Linux-enCaja/droidstamp-hw/droidstamp_mx233/DDR1.sch

## KiCad design droidstamp_mx233/DDR1.sch (2012-11-19)

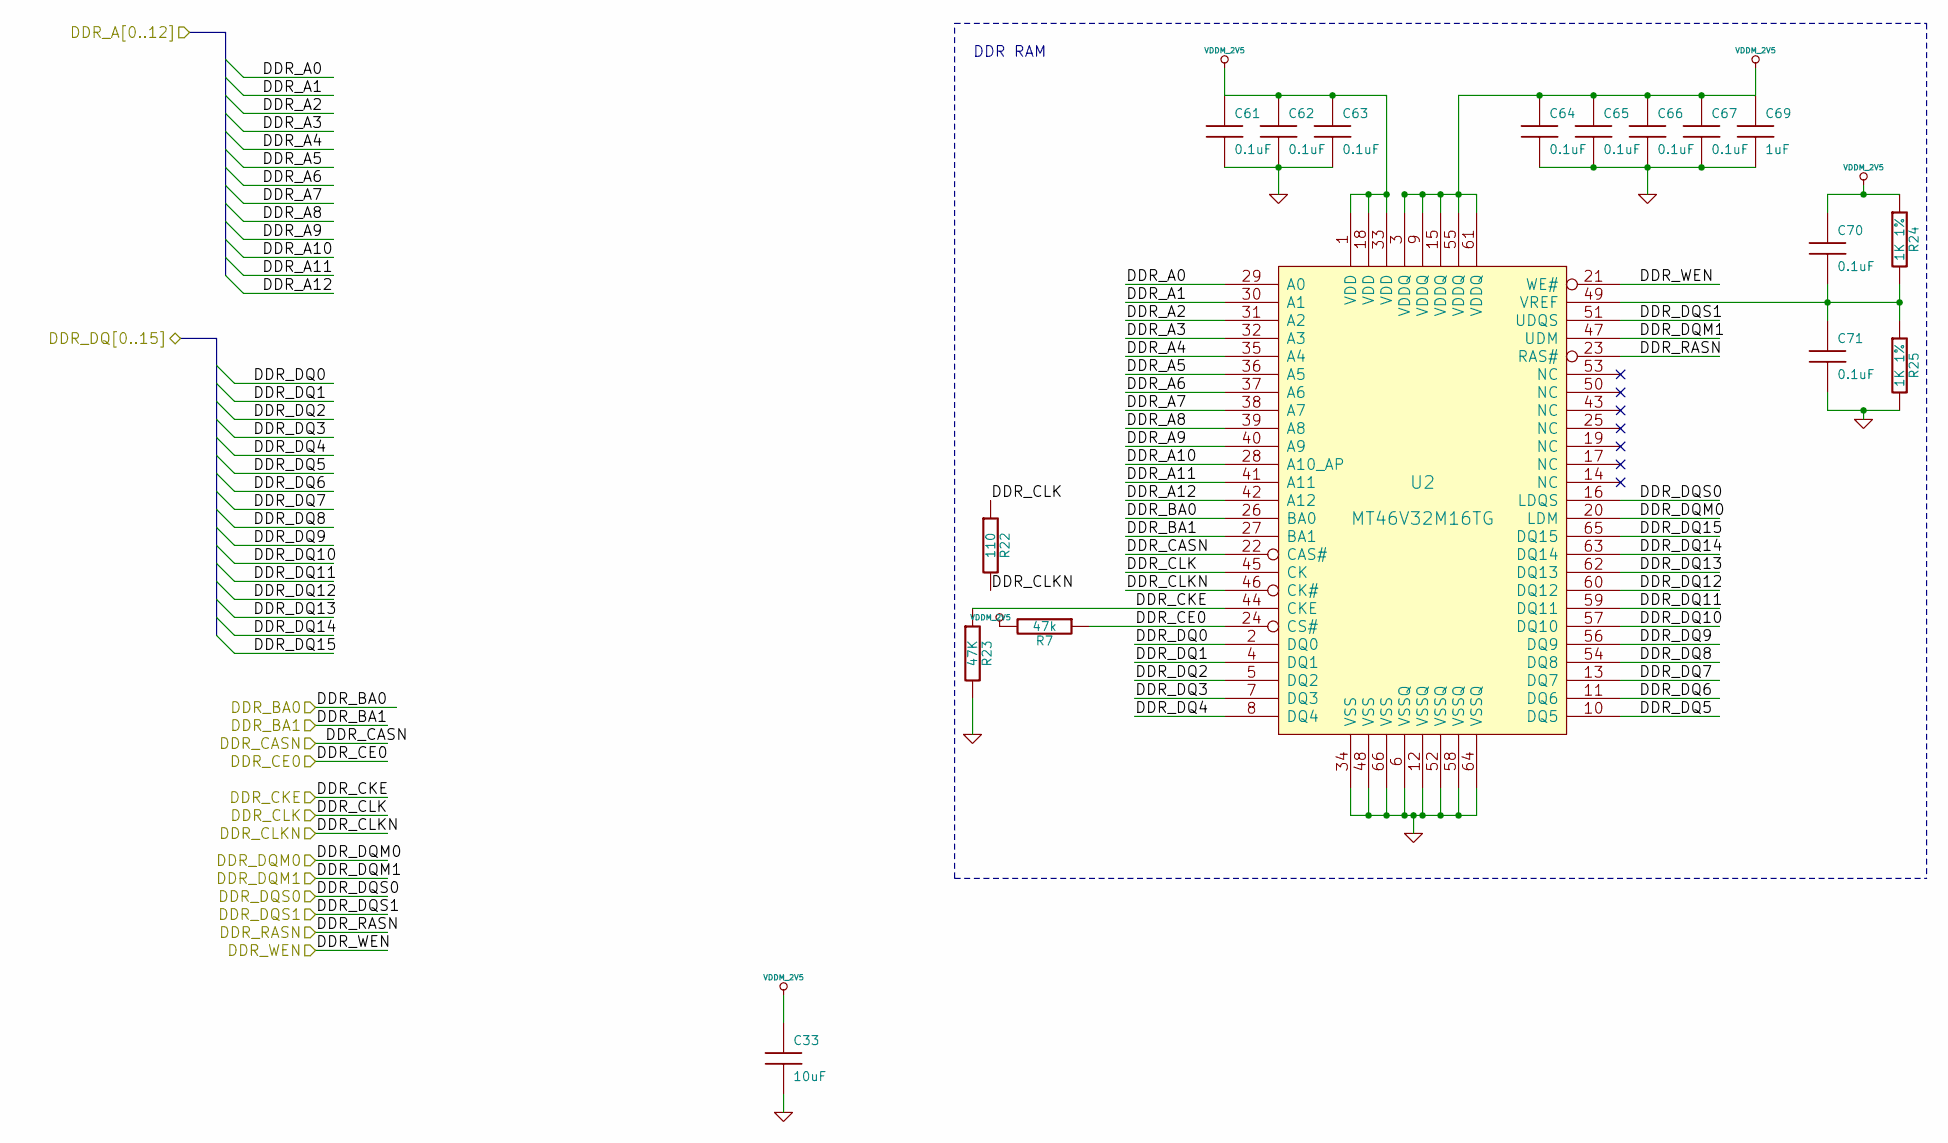
[picture p1: schematic DDR1.sch]

Parts:
C33: 10uF; SM1206
C61, C62, C63, C64, C65, C66, C67, C70, C71: 0.1uF
C69: 1uF
R7: 47k
R22: 110
R23: 47K
R24, R25: 1K 1%
U2: MT46V32M16TG; TSOP66_JEDEC_DDR_SDRAM

Connections:
DDR_A0: U2.29 (A0)
DDR_A1: U2.30 (A1)
DDR_A2: U2.31 (A2)
DDR_A3: U2.32 (A3)
DDR_A4: U2.35 (A4)
DDR_A5: U2.36 (A5)
DDR_A6: U2.37 (A6)
DDR_A7: U2.38 (A7)
DDR_A8: U2.39 (A8)
DDR_A9: U2.40 (A9)
DDR_A10: U2.28 (A10_AP)
DDR_A11: U2.41 (A11)
DDR_A12: U2.42 (A12)
DDR_BA0: U2.26 (BA0)
DDR_BA1: U2.27 (BA1)
DDR_CASN: U2.22 (CAS#)
DDR_CE0: R7.1, U2.24 (CS#)
DDR_CKE: R23.1, U2.44 (CKE)
DDR_CLK: R22.1, U2.45 (CK)
DDR_CLKN: R22.2, U2.46 (CK#)
DDR_DQ0: U2.2 (DQ0)
DDR_DQ1: U2.4 (DQ1)
DDR_DQ2: U2.5 (DQ2)
DDR_DQ3: U2.7 (DQ3)
DDR_DQ4: U2.8 (DQ4)
DDR_DQ5: U2.10 (DQ5)
DDR_DQ6: U2.11 (DQ6)
DDR_DQ7: U2.13 (DQ7)
DDR_DQ8: U2.54 (DQ8)
DDR_DQ9: U2.56 (DQ9)
DDR_DQ10: U2.57 (DQ10)
DDR_DQ11: U2.59 (DQ11)
DDR_DQ12: U2.60 (DQ12)
DDR_DQ13: U2.62 (DQ13)
DDR_DQ14: U2.63 (DQ14)
DDR_DQ15: U2.65 (DQ15)
DDR_DQM0: U2.20 (LDM)
DDR_DQM1: U2.47 (UDM)
DDR_DQS0: U2.16 (LDQS)
DDR_DQS1: U2.51 (UDQS)
DDR_RASN: U2.23 (RAS#)
DDR_WEN: U2.21 (WE#)
GND: C33.2, C61.2, C62.2, C63.2, C64.2, C65.2, C66.2, C67.2, C69.2, C71.2, R23.2, R25.2, U2.6 (VSSQ), U2.12 (VSSQ), U2.34 (VSS), U2.48 (VSS), U2.52 (VSSQ), U2.58 (VSSQ), U2.64 (VSSQ), U2.66 (VSS)
unnamed: C70.2, C71.1, R24.2, R25.1, U2.49 (VREF)
VDDM_2V5: C33.1, C61.1, C62.1, C63.1, C64.1, C65.1, C66.1, C67.1, C69.1, C70.1, R7.2, R24.1, U2.1 (VDD), U2.3 (VDDQ), U2.9 (VDDQ), U2.15 (VDDQ), U2.18 (VDD), U2.33 (VDD), U2.55 (VDDQ), U2.61 (VDDQ)

Notes on the sheet:
DDR RAM
