Linux-enCaja/droidstamp-hw/droidstamp_mx233/STM32.sch

## KiCad design droidstamp_mx233/STM32.sch (2012-11-19)

Schematic: STM32.sch

Parts:
C19, C21: 2.2uF; SM0805
C26, C28: 22pF; SM0603
C54: .1uF; SM0603
C55, C56, C58, C72: 0.1uF; SM0603
C59: 10uF Tant.; SM1206
C73: 1uF; SM0805
C74, C76: 33uF; SM1206
C75: 100n; SM0603
D8, D9: LED; SM0603
L14, L15: 2A 120 ohm; SM0805
P6: CONN_10X2; pin_array_10x2
P8: CONN_12X2; pin_array_12x2
P9: CONN_8X2; pin_array_12x2
Q2, Q3, Q4, Q5, Q6, Q7, Q8, Q9: BS170F
R5, R33: 1k; SM0603
R26, R47: 4.7k; SM0603
R27, R34: 10k; SM0603
R35, R37, R38, R39, R40, R41, R44, R45: 2.2k; SM0603
R46: 150; SM0603
U10: STM32F105RC; TQFP_64
U11: LT1117CST-3.3; LT1117
U12, U13, U14, U15: ZXMHC3F381N8; -SO8
X3: 12MHz; ABM8G

Notes on the sheet:
C19, C21 2.2uF para cortex M4 C19. C21 = Ohms para cortex M3
DECOUPLING
LEDS
