Linux-enCaja/droidstamp-hw/droidstamp_mx233/i.MX233.sch

## KiCad design droidstamp_mx233/i.MX233.sch (2012-11-19)

Schematic: i.MX233.sch

Parts:
BT1: BATTERY
C1, C2, C3, C5, C23, C24, C31, C32, C37, C41, C44, C46, C47, C49, C51, C57, C60, C68: 0.1uF
C4: .1uF
C17, C25, C29, C38, C42, C43, C50: 1uF
C22, C30, C36, C45: 0.01uF
C27, C35, C39: 33uF
C34: 4.7uF
C40, C48: 33uF Ceramic
C52, C53: 20 pF
D1: 10BQ015
D2, D3, D4, D5: LED
IC1: iMX233
J1: MICROSD
J5: JACK-PLUG; DC_JACK
JP1, JP2, JP3: JUMPER
L1: 15uH
L2, L8: HZ0805D152R-10 (1500 ohm)
L11, L12, L13: HZ0805D152R-10 (1500 ohm); SM0805
P1: CONN_12X2
P2: CONN_12X2
P3, P5, P7, P10: CONN_1; MHOLE
P4: CONN_4X2
Q1: MMDT3904; SOT363_PHILIPS
R1: 1
R2, R3: 0.1
R4: 1K
R6: 100K
R8, R51, R52: 10k
R9, R13, R16, R28, R30, R31: 1k
R10: 47K
R11, R12, R14: 1.5k
R15, R17, R18, R19: 11k
R29, R32: 47k
U1: ADM3101E; QSOP16
U3: M25P32; SO16W
X1: 24MHz; ABM8G

Notes on the sheet:
Para hacer boot por la SD soldar R48, R49 no se solda Para hacer boot por la memoria SPI soldar R49, R48 no se solda
ADM3101E CIRCUIT
UART CONNECTOR
Power Supply
MICRO_SD
USB CONNECTOR
IMX233 PROCESSOR
POWER SUPPLY AND DECOUPLING
BOOT MODES
RESET CIRCUIT
