Linux-enCaja/droidstamp-hw/droidstamp_pcb_emeter/STM32.sch

## KiCad design droidstamp_pcb_emeter/STM32.sch (2012-08-21)

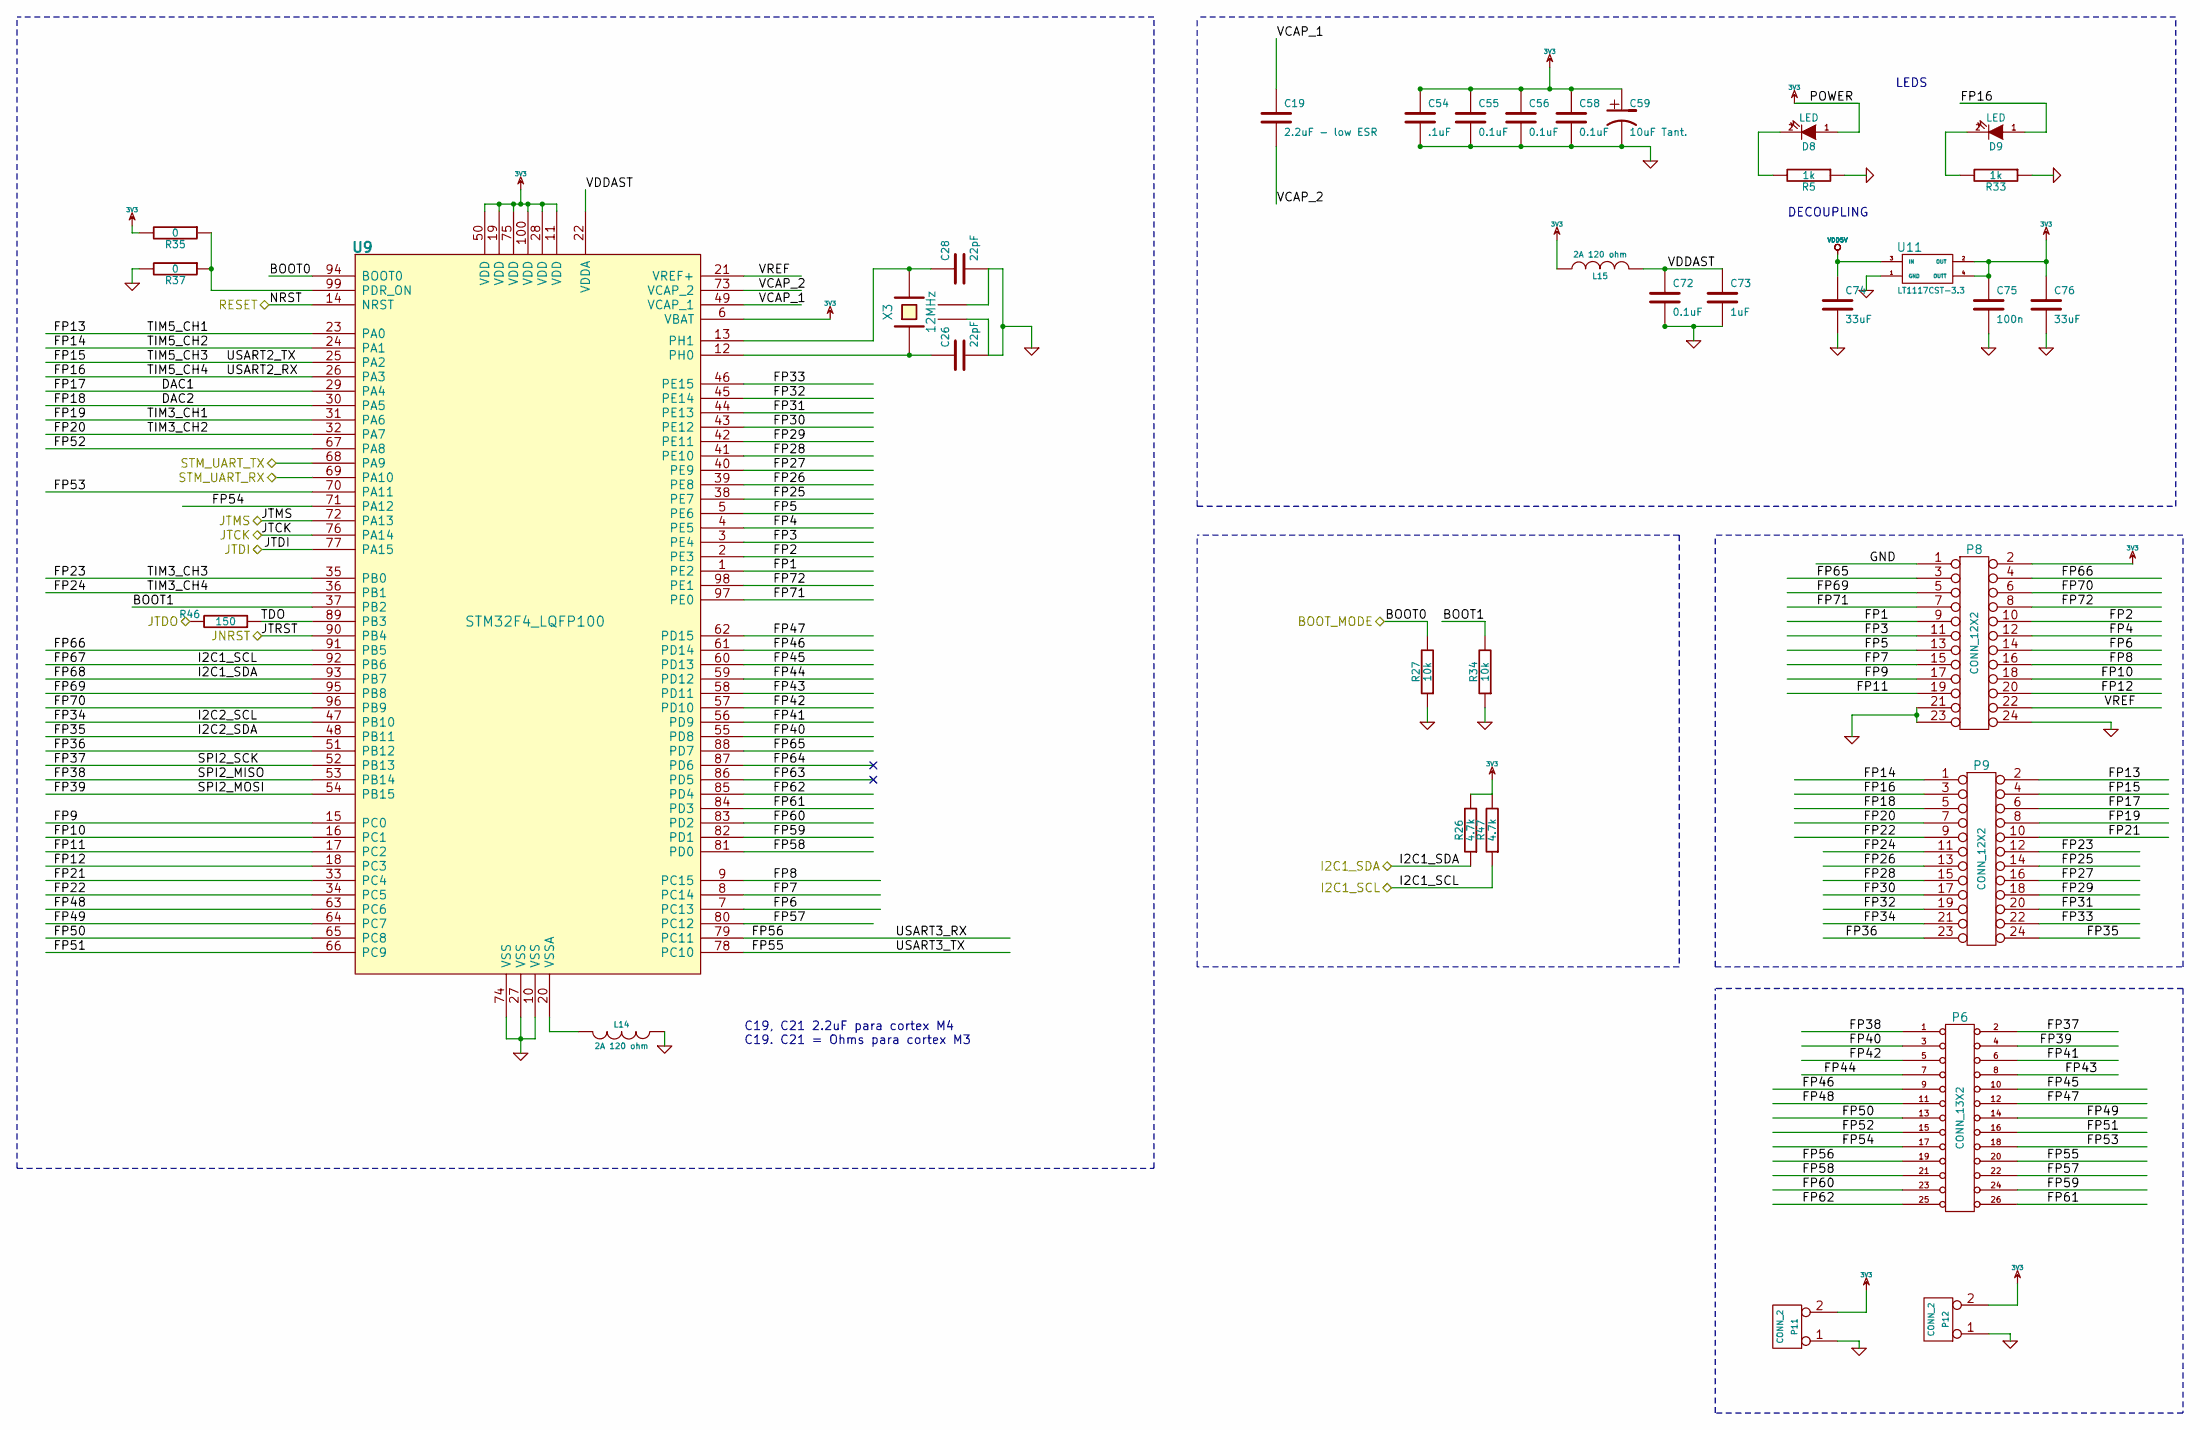
[picture p3: schematic STM32.sch]

Parts:
C19: 2.2uF - low ESR; SM0603
C26, C28: 22pF; SM0603
C54: .1uF; SM0603
C55, C56, C58, C72: 0.1uF; SM0603
C59: 10uF Tant.; SM1206
C73: 1uF; SM0805
C74, C76: 33uF; SM1206
C75: 100n; SM0603
D8, D9: LED; SM0603
L14, L15: 2A 120 ohm; SM0805
P6: CONN_13X2
P8: CONN_12X2
P9: CONN_12X2; pin_array_12x2
P11, P12: CONN_2
R5, R33: 1k; SM0603
R26, R47: 4.7k; SM0603
R27, R34: 10k; SM0603
R35, R37: 0
R46: 150; SM0603
U9: STM32F4_LQFP100; TQFP_100
U11: LT1117CST-3.3; LT1117
X3: 12MHz; ABM8G

Connections:
3V3: C54.1, C55.1, C56.1, C58.1, C59.1, C75.1, C76.1, D8.1 (A), L15.1, P8.2, P11.2 (PM), P12.2 (PM), R26.2, R35.2, R47.2, U9.6 (VBAT), U9.11 (VDD), U9.19 (VDD), U9.28 (VDD), U9.50 (VDD), U9.75 (VDD), U9.100 (VDD), U11.2 (OUT), U11.4 (OUTT)
BOOT0: R27.2, U9.94 (BOOT0)
BOOT1: R34.2, U9.37 (PB2)
DAC1: P9.6, U9.29 (PA4)
DAC2: P9.5, U9.30 (PA5)
FP1: P8.9, U9.1 (PE2)
FP2: P8.10, U9.2 (PE3)
FP3: P8.11, U9.3 (PE4)
FP4: P8.12, U9.4 (PE5)
FP5: P8.13, U9.5 (PE6)
FP6: P8.14, U9.7 (PC13)
FP7: P8.15, U9.8 (PC14)
FP8: P8.16, U9.9 (PC15)
FP9: P8.17, U9.15 (PC0)
FP10: P8.18, U9.16 (PC1)
FP11: P8.19, U9.17 (PC2)
FP12: P8.20, U9.18 (PC3)
FP13: P9.2, U9.23 (PA0)
FP14: P9.1, U9.24 (PA1)
FP15: P9.4, U9.25 (PA2)
FP16: D9.1 (A), P9.3, U9.26 (PA3)
FP19: P9.8, U9.31 (PA6)
FP20: P9.7, U9.32 (PA7)
FP21: P9.10, U9.33 (PC4)
FP22: P9.9, U9.34 (PC5)
FP23: P9.12, U9.35 (PB0)
FP24: P9.11, U9.36 (PB1)
FP25: P9.14, U9.38 (PE7)
FP26: P9.13, U9.39 (PE8)
FP27: P9.16, U9.40 (PE9)
FP28: P9.15, U9.41 (PE10)
FP29: P9.18, U9.42 (PE11)
FP30: P9.17, U9.43 (PE12)
FP31: P9.20, U9.44 (PE13)
FP32: P9.19, U9.45 (PE14)
FP33: P9.22, U9.46 (PE15)
FP34: P9.21, U9.47 (PB10)
FP35: P9.24, U9.48 (PB11)
FP36: P9.23, U9.51 (PB12)
FP37: P6.2, U9.52 (PB13)
FP38: P6.1, U9.53 (PB14)
FP39: P6.4, U9.54 (PB15)
FP40: P6.3, U9.55 (PD8)
FP41: P6.6, U9.56 (PD9)
FP42: P6.5, U9.57 (PD10)
FP43: P6.8, U9.58 (PD11)
FP44: P6.7, U9.59 (PD12)
FP45: P6.10, U9.60 (PD13)
FP46: P6.9, U9.61 (PD14)
FP47: P6.12, U9.62 (PD15)
FP48: P6.11, U9.63 (PC6)
FP49: P6.14, U9.64 (PC7)
FP50: P6.13, U9.65 (PC8)
FP51: P6.16, U9.66 (PC9)
FP52: P6.15, U9.67 (PA8)
FP53: P6.18, U9.70 (PA11)
FP54: P6.17, U9.71 (PA12)
FP55: P6.20, U9.78 (PC10)
FP56: P6.19, U9.79 (PC11)
FP57: P6.22, U9.80 (PC12)
FP58: P6.21, U9.81 (PD0)
FP59: P6.24 (P20), U9.82 (PD1)
FP60: P6.23, U9.83 (PD2)
FP61: P6.26 (P22), U9.84 (PD3)
FP62: P6.25 (P24), U9.85 (PD4)
FP63: U9.86 (PD5)
FP64: U9.87 (PD6)
FP65: P8.3, U9.88 (PD7)
FP66: P8.4, U9.91 (PB5)
FP67: R47.1, U9.92 (PB6)
FP68: R26.1, U9.93 (PB7)
FP69: P8.5, U9.95 (PB8)
FP70: P8.6, U9.96 (PB9)
FP71: P8.7, U9.97 (PE0)
FP72: P8.8, U9.98 (PE1)
GND: C26.2, C28.2, C54.2, C55.2, C56.2, C58.2, C59.2, C72.2, C73.2, C74.2, C75.2, C76.2, L14.1, P8.1, P8.21, P8.23, P8.24, P11.1, P12.1, R5.1, R27.1, R33.1, R34.1, R37.2, U9.10 (VSS), U9.27 (VSS), U9.74 (VSS), U11.1 (GND), X3.2 (GND), X3.4 (GND)
JNRST: U9.90 (PB4)
JTCK: U9.76 (PA14)
JTDI: U9.77 (PA15)
JTDO: R46.2
JTMS: U9.72 (PA13)
NRST: U9.14 (NRST)
unnamed: C26.1, U9.12 (PH0), X3.1
unnamed: C28.1, U9.13 (PH1), X3.3
unnamed: D8.2 (K), R5.2
unnamed: D9.2 (K), R33.2
unnamed: L14.2, U9.20 (VSSA)
unnamed: R35.1, R37.1, U9.99 (PDR_ON)
STM_UART_RX: U9.69 (PA10)
STM_UART_TX: U9.68 (PA9)
TDO: R46.1, U9.89 (PB3)
VCAP_1: C19.1, U9.49 (VCAP_1)
VCAP_2: C19.2, U9.73 (VCAP_2)
VDD5V: C74.1, U11.3 (IN)
VDDAST: C72.1, C73.1, L15.2, U9.22 (VDDA)
VREF: P8.22, U9.21 (VREF+)

Notes on the sheet:
C19, C21 2.2uF para cortex M4 C19. C21 = Ohms para cortex M3
DECOUPLING
LEDS
