Linux-enCaja/droidstamp-hw/droidstamp_pcb_lt/USB.sch

## KiCad design droidstamp_pcb_lt/USB.sch (2012-06-18, an earlier design)

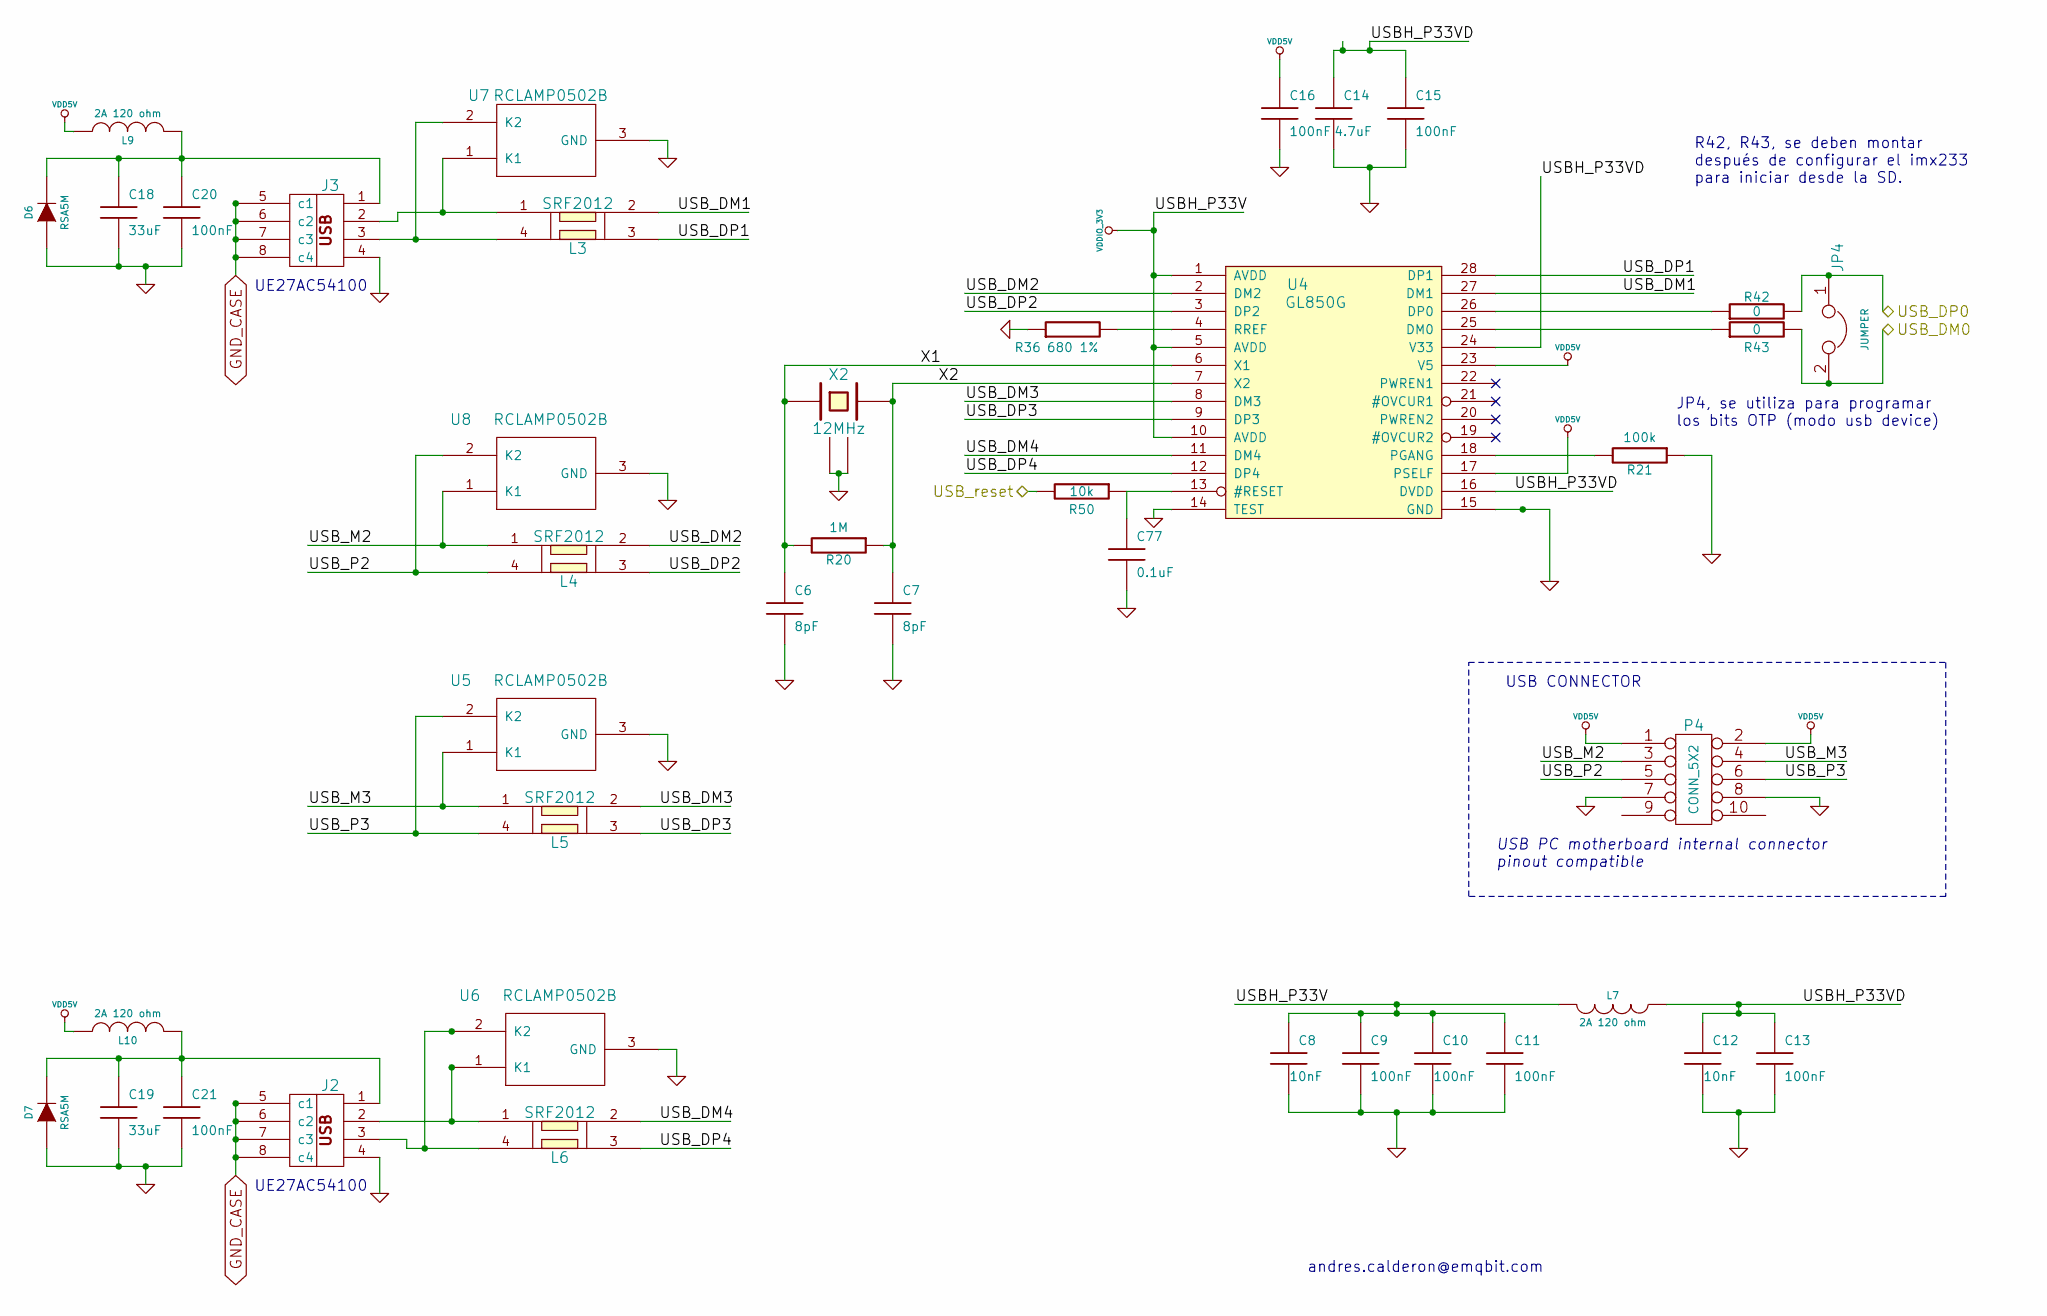
[picture p4: schematic USB.sch]

Parts:
C6, C7: 8pF; SM0603
C8, C12: 10nF; SM0603
C9, C10, C11, C13, C15, C16, C20, C21: 100nF; SM0603
C14: 4.7uF; SM1206
C18, C19: 33uF; SM1206
C77: 0.1uF; SM0603
D6: RSA5M; diode-1-SOD123
D7: RSA5M
J2: USB_2A; CONN_USB-A_Vertical_Opendous
J3: USB_2A
JP4: JUMPER; PIN_ARRAY_2X1
L3, L4, L5, L6: SRF2012
L7, L9, L10: 2A 120 ohm; SM0805
P4: CONN_5X2; PIN_ARRAY_5x2
R20: 1M; SM0603
R21: 100k; SM0603
R36: 680 1%; SM0603
R42, R43: 0; SM0603
R50: 10k; SM0603
U4: GL850G; TSSOP28
U5, U6, U7, U8: RCLAMP0502B; SOD523
X2: 12MHz; ABM8G

Connections:
GND: C6.2, C7.2, C8.2, C9.2, C10.2, C11.2, C12.2, C13.2, C14.2, C15.2, C16.2, C18.2, C19.2, C20.2, C21.2, C77.2, D6.1 (A), D7.1 (A), J2.4, J3.4, P4.7, P4.8, R21.1, R36.1, U4.14 (TEST), U4.15 (GND), U5.3 (GND), U6.3 (GND), U7.3 (GND), U8.3 (GND), X2.2 (GND), X2.4 (GND)
GND_CASE: J2.5 (c1), J2.6 (c2), J2.7 (c3), J2.8 (c4), J3.5 (c1), J3.6 (c2), J3.7 (c3), J3.8 (c4)
unnamed: C18.1, C20.1, D6.2 (K), J3.1, L9.2
unnamed: C19.1, C21.1, D7.2 (K), J2.1, L10.2
unnamed: C77.1, R50.1, U4.13 (#RESET)
unnamed: J2.2, L6.1, U6.1 (K1)
unnamed: J2.3, L6.4, U6.2 (K2)
unnamed: J3.2, L3.1, U7.1 (K1)
unnamed: J3.3, L3.4, U7.2 (K2)
unnamed: R21.2, U4.18 (PGANG)
unnamed: R36.2, U4.4 (RREF)
unnamed: R42.1, U4.26 (DP0)
unnamed: R43.1, U4.25 (DM0)
USBH_P33VD: C12.1, C13.1, C14.1, C15.1, L7.1, U4.16 (DVDD), U4.24 (V33)
USB_DM0: JP4.2, R43.2
USB_DM1: L3.2, U4.27 (DM1)
USB_DM2: L4.2, U4.2 (DM2)
USB_DM3: L5.2, U4.8 (DM3)
USB_DM4: L6.2, U4.11 (DM4)
USB_DP0: JP4.1, R42.2
USB_DP1: L3.3, U4.28 (DP1)
USB_DP2: L4.3, U4.3 (DP2)
USB_DP3: L5.3, U4.9 (DP3)
USB_DP4: L6.3, U4.12 (DP4)
USB_M2: L4.1, P4.3, U8.1 (K1)
USB_M3: L5.1, P4.4, U5.1 (K1)
USB_P2: L4.4, P4.5, U8.2 (K2)
USB_P3: L5.4, P4.6, U5.2 (K2)
USB_reset: R50.2
VDD5V: C16.1, L9.1, L10.1, P4.1, P4.2, U4.17 (PSELF), U4.23 (V5)
VDDIO_3V3: C8.1, C9.1, C10.1, C11.1, L7.2, U4.1 (AVDD), U4.5 (AVDD), U4.10 (AVDD)
X1: C6.1, R20.2, U4.6 (X1), X2.1
X2: C7.1, R20.1, U4.7 (X2), X2.3

Notes on the sheet:
UE27AC54100
JP4, se utiliza para programar los bits OTP (modo usb device)
R42, R43, se deben montar después de configurar el imx233 para iniciar desde la SD.
andres.calderon@emqbit.com
USB CONNECTOR
USB PC motherboard internal connector pinout compatible
