Linux-enCaja/droidstamp-hw/(commit log)

2012-03-29 initial import from linuxencaja robotica rep.
    [DDR1.sch, POWER.sch, POWER_SUPPLY.sch, STM32.sch, USB.sch, i.MX233.sch, i.mx233stamp.brd, i.mx233stamp.sch]
2012-03-30 se inserto el smt32f4
    [DDR1.sch, STM32.sch, USB.sch, i.MX233.sch, i.mx233stamp.brd, i.mx233stamp.sch]
2012-04-01 sync with las sie_bot_v2
    [DDR1.sch, STM32.sch, USB.sch, i.MX233.sch, i.mx233stamp.brd, i.mx233stamp.sch]
2012-04-01 mas conexiones al stm32f4
    [DDR1.sch, STM32.sch, USB.sch, i.MX233.sch, i.mx233stamp.brd, i.mx233stamp.sch]
2012-04-01 stm32f4 initial placement
    [i.mx233stamp.brd]
2012-04-10 osc has been connected
    [DDR1.sch, STM32.sch, USB.sch, i.MX233.sch, i.mx233stamp.brd, i.mx233stamp.sch]
2012-04-12 EMF Feedback For M1 -- Incomplete. Must include module for SN74CBT1G125.
    For the moment it is a 74LS125 which conceptually is somehow similar.
    [STM32.sch]
2012-04-17 Library for sn74cbt1g125. TODO: current sensing.
    [DDR1.sch, STM32.sch, USB.sch, i.MX233.sch, i.mx233stamp.sch]
2012-04-18 Current sense for M1 -- taken from openservo.
    [DDR1.sch, STM32.sch, USB.sch, i.MX233.sch, i.mx233stamp.sch]
2012-04-19 Feedback for motors 1 and 2 in different sheet. Current feedback for M1 and M2.
    Connection between digital ground and motor ground by means of an inductor.
    [DDR1.sch, STM32.sch, USB.sch, i.MX233.sch, i.mx233stamp.sch, motors_feedback_drivers.sch]
2012-04-20 droidstamp_pcb_emeter added
    [DDR1.sch, POWER.sch, POWER_SUPPLY.sch, STM32.sch, USB.sch, i.MX233.sch, i.mx233stamp.brd, i.mx233stamp.sch]
2012-04-20 Current sensing separated in the feedback_drivers sheet.
    [DDR1.sch, STM32.sch, USB.sch, i.MX233.sch, i.mx233stamp.sch, motors_feedback_drivers.sch]
2012-04-20 Component Mask fixed
    [i.mx233stamp.brd]
2012-04-20 Fixed some routing and PCB paths
    [DDR1.sch, STM32.sch, USB.sch, i.MX233.sch, i.mx233stamp.brd, i.mx233stamp.sch]
2012-04-27 Corrección de la capa de silkscreen se eliminaron los nombres del conector
    [i.mx233stamp.brd]
2012-05-01 Fixed SilkScreen and Ribbon connectors problem
    [DDR1.sch, STM32.sch, USB.sch, i.MX233.sch, i.mx233stamp.brd, i.mx233stamp.sch]
2012-05-01 Fixed SilkS problem
    [DDR1.sch, STM32.sch, USB.sch, i.MX233.sch, i.mx233stamp.brd, i.mx233stamp.sch]
2012-05-01 Fixed Hole 1st pins
    [i.mx233stamp.brd]
2012-06-17 droidstamp_pcb_lt has beed added
    [DDR1.sch, POWER.sch, POWER_SUPPLY.sch, STM32.sch, USB.sch, i.MX233.sch, i.mx233stamp.brd, i.mx233stamp.sch]
2012-06-18 USB PC compatible connector
    [DDR1.sch, USB.sch, i.MX233.sch, i.mx233stamp.brd, i.mx233stamp.sch]
2012-06-18 pcb outline
    [i.mx233stamp.brd]
2012-06-18 ratnets revision
    [DDR1.sch, USB.sch, i.MX233.sch, i.mx233stamp.brd, i.mx233stamp.sch]
2012-06-26 fix labels
    [i.mx233stamp.brd]
2012-08-21 Adición de la linea BOOT_MODE para modificar el inicio del stm32 desde memoria interna o jtag
    [DDR1.sch, POWER.sch, POWER_SUPPLY.sch, STM32.sch, USB.sch, i.MX233.sch, i.mx233stamp.brd, i.mx233stamp.sch]
2012-08-22 main droidstamp added
    [DDR1.sch, POWER.sch, POWER_SUPPLY.sch, STM32.sch, USB.sch, i.MX233.sch, i.mx233stamp.brd, i.mx233stamp.csv]
2012-08-26 fix power jack
    [DDR1.sch, STM32.sch, USB.sch, i.MX233.sch, i.mx233stamp.brd, i.mx233stamp.sch]
2012-08-27 Se arreglaron algunas no conexiones
    [i.mx233stamp.brd]
2012-08-27 fix 3.3V zone
    [i.mx233stamp.brd]
2012-08-28 logos has been added
    [i.mx233stamp.brd]
2012-08-28 REG3V3 moved
    [i.mx233stamp.brd]
2012-08-29 minor style improvements
    [i.mx233stamp.brd]
2012-08-31 Se eliminó una via que no conectaba a ninguna señal, derectado por ME
    [i.mx233stamp.brd]
2012-09-05 fix logo
    [i.mx233stamp.brd, i.mx233stamp.csv]
2012-09-13 Pull-Up resistors SPI
    [$savepcb.brd]
2012-11-19 TODO file added
    [DDR1.sch, STM32.sch, USB.sch, i.MX233.sch, i.mx233stamp.brd, i.mx233stamp.csv, i.mx233stamp.sch]
