Linux-enCaja/droidstamp-hw/(notices)

Notices in the files:
droidstamp_mx233/$savepcb.brd:
CC-BY-SA
